supertornado666/-STM32-/(list of files, drawings)

Other design files:
ProPrj_STM32数字多用表_2024-12-06.epro
